Greg-R/qsd2/README.md

QSD2 Receiver Module

The documentation for this design is located here:
<https://kf5n.com/t41-2/qsd2ez/>
