Greg-R/qsd2/doc/qsd2.pdf

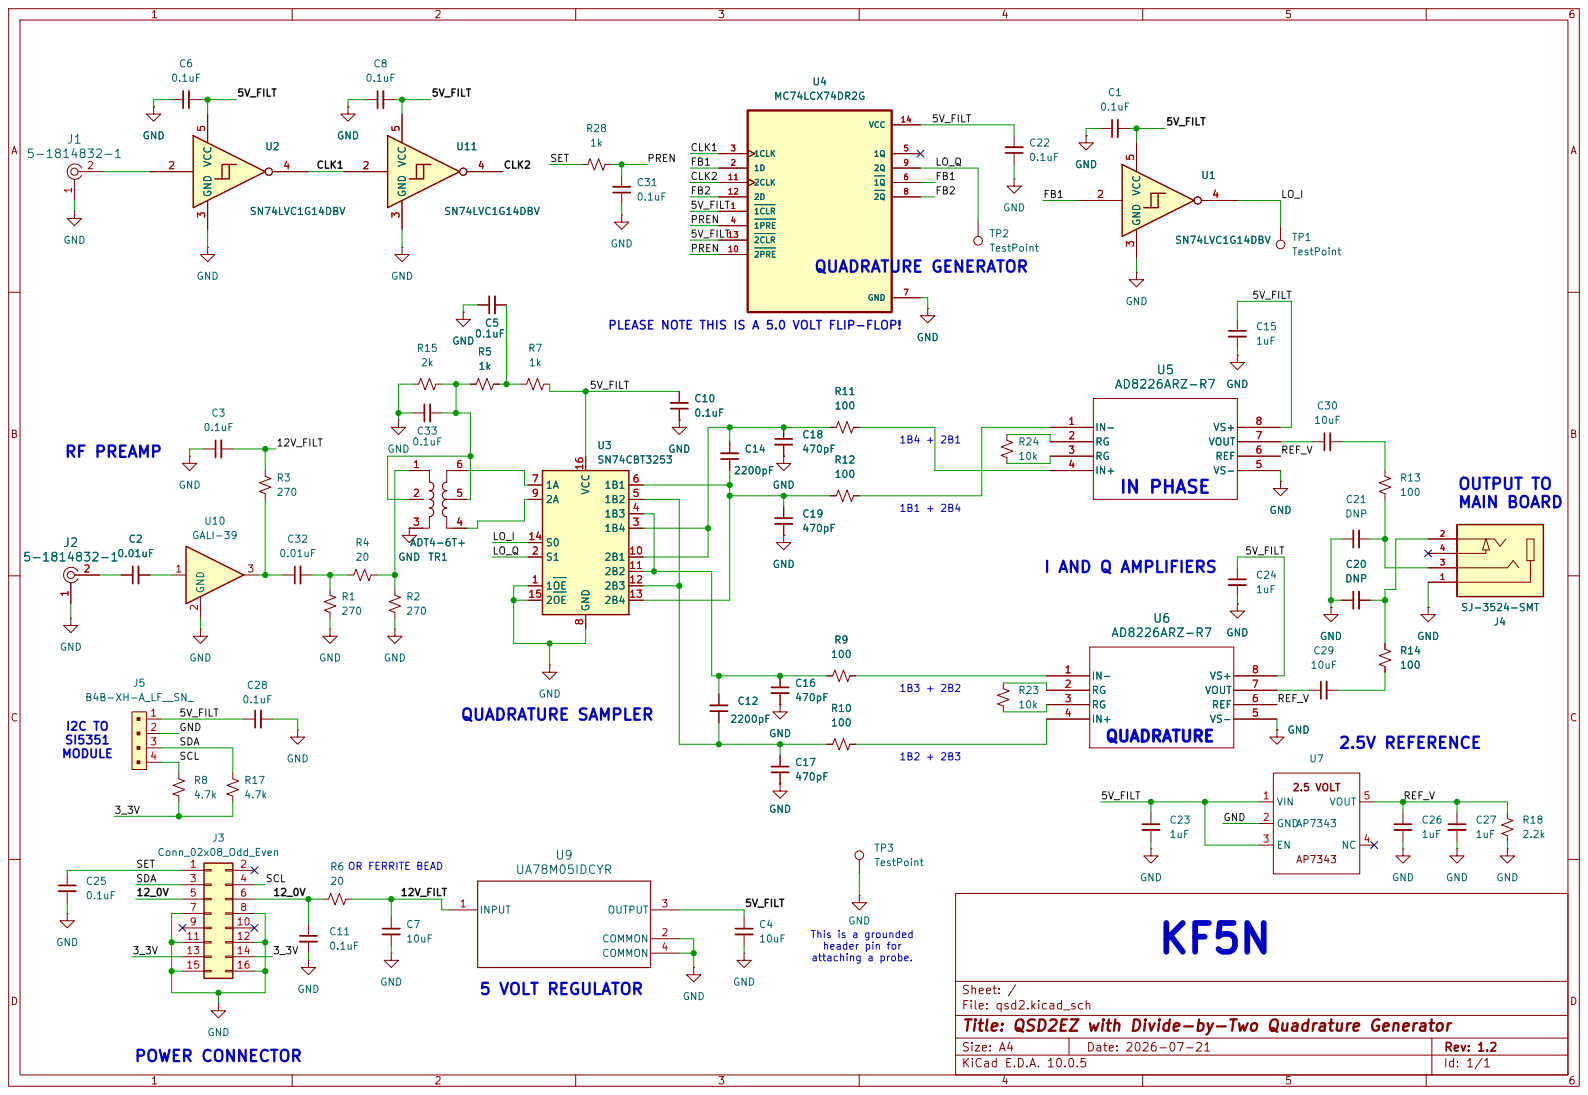
[picture p1: page 1]

This is a grounded
header pin for attaching a probe.

Sheet: /
File: qsd2.kicad_sch
Title: QSD2EZ with Divide-by-Two Quadrature Generator

Size: A4 | Rev: 1.2
KiCad E.D.A. 10.0.5 | Id: 1/1
