Greg-R/qsd2/qsd2.kicad_pcb

## KiCad design qsd2.kicad_pcb (2026-07-24)

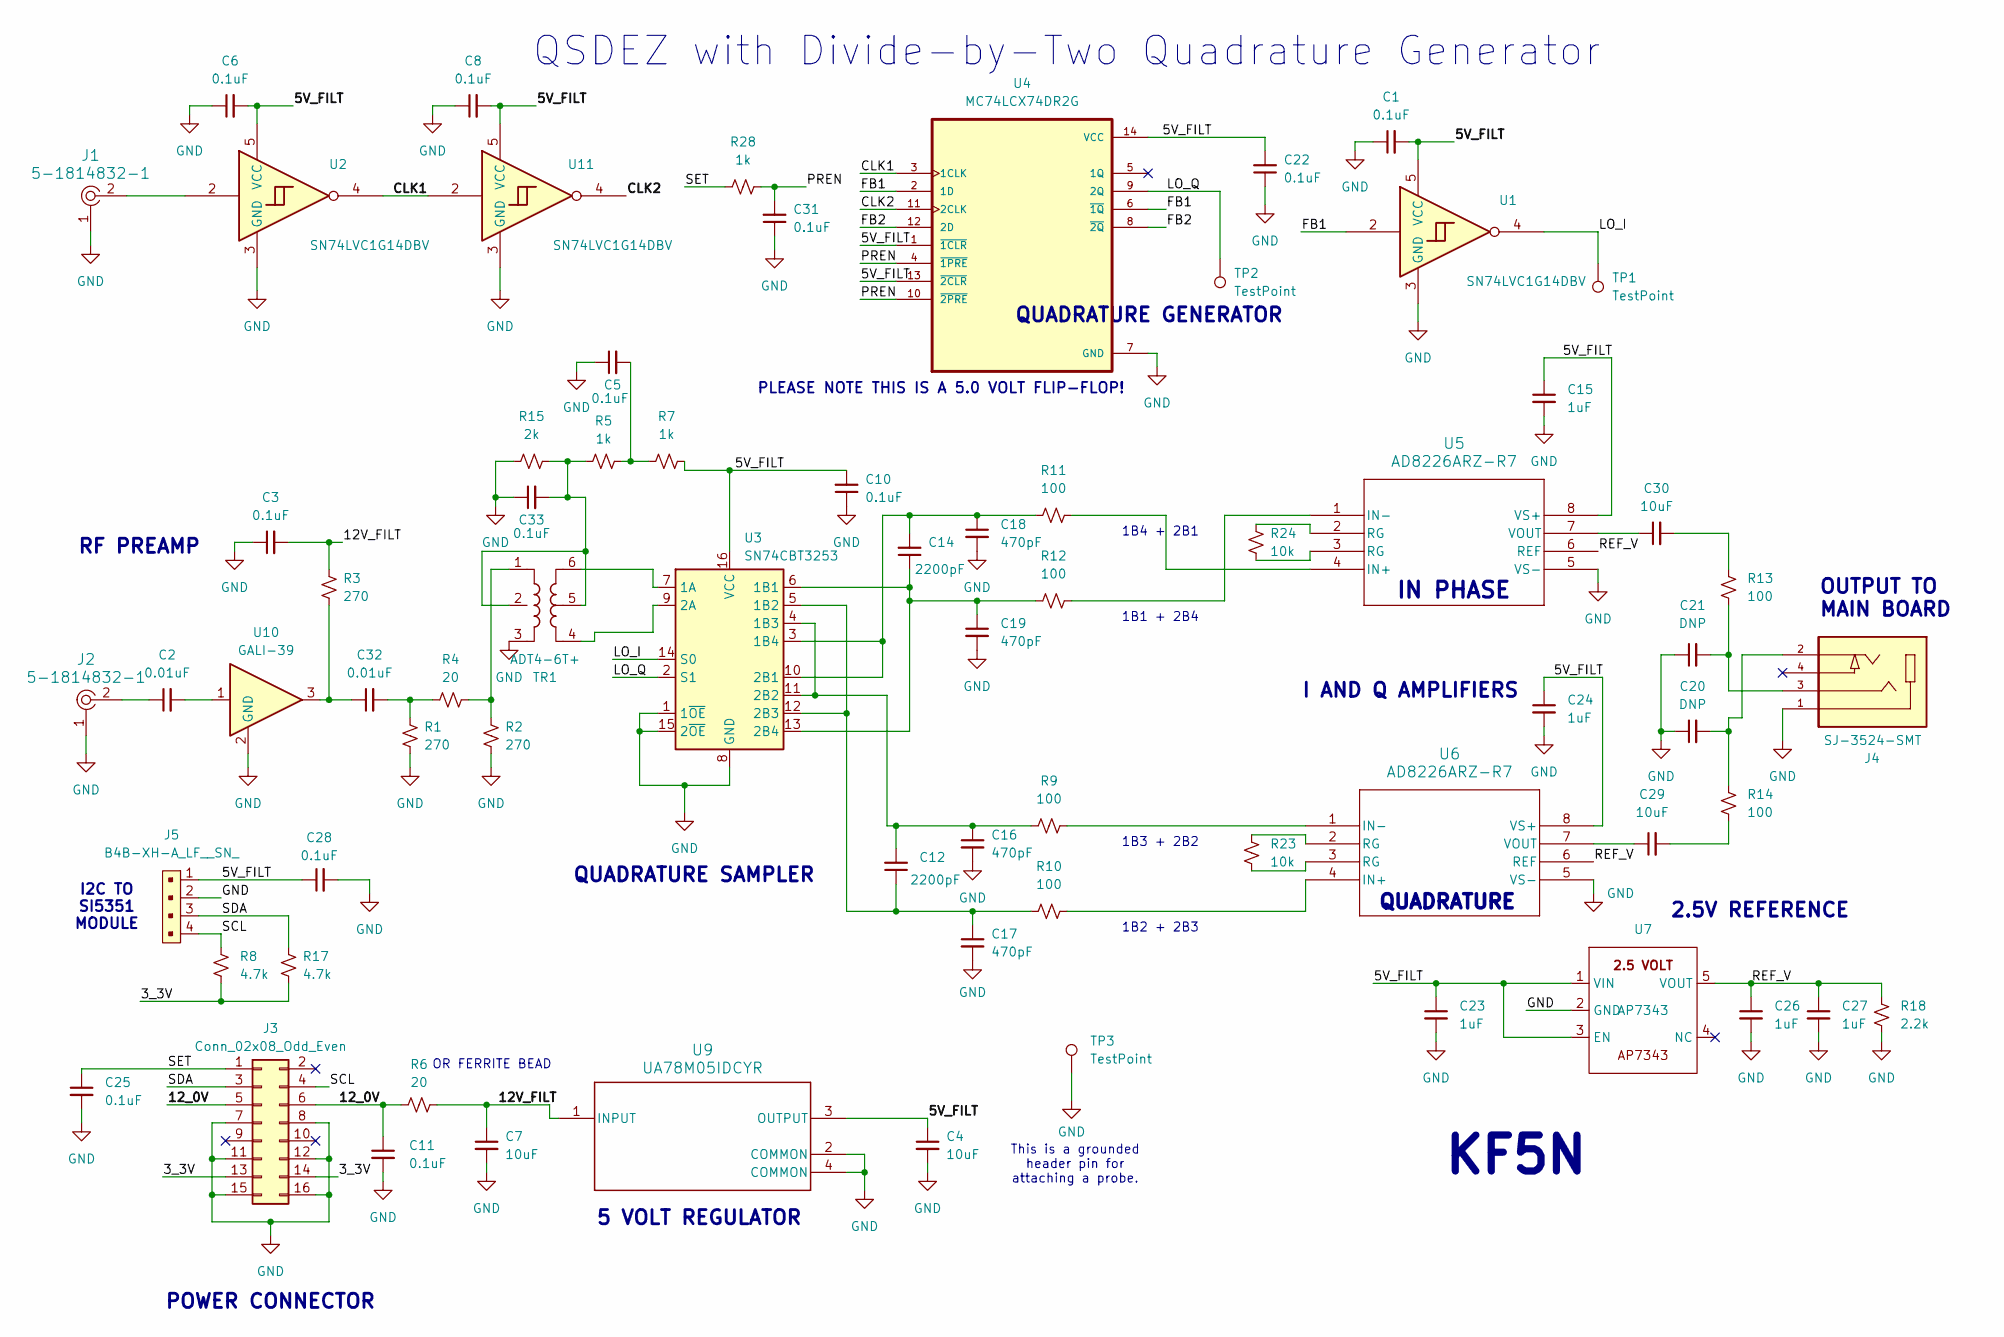
[picture p2: schematic qsd2.kicad_sch, QSD2EZ with Divide-by-Two Quadrature Generator]

Parts:
C1, C3, C5, C6, C8, C10, C11, C22, C25, C28, C31, C33: 0.1uF; C_1206_3216Metric
C2, C32: 0.01uF; C_1206_3216Metric
C4, C7, C29, C30: 10uF; C_1206_3216Metric
C12, C14: 2200pF; C_1206_3216Metric
C15, C23, C24, C26, C27: 1uF; C_1206_3216Metric
C16, C17, C18, C19: 470pF; C_1206_3216Metric
C20, C21: DNP; C_1206_3216Metric
J1, J2: 5-1814832-1; RF_SMA_Vertical_5-1814832-1; MPN 5-1814832-1; Digi-Key_PN A97594-ND
J3: Conn_02x08_Odd_Even; IDC-Header_2x08_P2.54mm_Vertical
J4: SJ-3524-SMT; CUI_SJ-3524-SMT; PARTREV 1.03
J5: B4B-XH-A_LF__SN_; PinHeader_1x4_P2.5mm_Drill1.1mm; MPN B4B-XH-A(LF)(SN); Digi-Key_PN 455-2249-ND
R1, R2, R3: 270; R_1206_3216Metric
R4, R6: 20; R_1206_3216Metric
R5, R7, R28: 1k; R_1206_3216Metric
R8, R17: 4.7k; R_1206_3216Metric
R9, R10, R11, R12, R13, R14: 100; R_1206_3216Metric
R15: 2k; R_1206_3216Metric
R18: 2.2k; R_1206_3216Metric
R23, R24: 10k; R_1206_3216Metric
TP1, TP2: TestPoint; TestPoint_Pad_D1.0mm
TP3: TestPoint; PinHeader_1x01_P2.54mm_Vertical
TR1: ADT4-6T+; Mini-Circuits_CD637_H5.23mm
U1, U2, U11: SN74LVC1G14DBV; SOT-23-5
U3: SN74CBT3253; SOIC-16_3.9x9.9mm_P1.27mm
U4: MC74LCX74DR2G; SOIC-14_3.9x8.7mm_P1.27mm
U5, U6: AD8226ARZ-R7; R_8_ADI
U7: AP7343; SOT-23-5
U9: UA78M05IDCYR; DCY0004A_N
U10: GALI-39; SOT-89-3

Connections:
/3_3V: J3.13, J3.14, R8.2, R17.2
/5V_FILT: C1.2, C4.1, C6.2, C8.2, C10.2, C15.1, C22.2, C23.1, C24.1, C28.1, J5.1, R7.2, U1.5 (VCC), U2.5 (VCC), U3.16 (VCC), U4.1 (~1CLR), U4.13 (~2CLR), U4.14 (VCC), U5.8 (VS+), U6.8 (VS+), U7.1 (VIN), U7.3 (EN), U9.3 (OUTPUT), U11.5 (VCC)
/12V_FILT: C3.2, C7.1, R3.1, R6.2, U9.1 (INPUT)
/12_0V: C11.1, J3.5, J3.6, R6.1
/CLK1: U2.4, U4.3 (1CLK), U11.2
/CLK2: U4.11 (2CLK), U11.4
/FB1: U1.2, U4.2 (1D), U4.6 (~1Q)
/FB2: U4.8 (~2Q), U4.12 (2D)
/LO_I: TP1.1 (1_1), U1.4, U3.14 (S0)
/LO_Q: TP2.1 (1_1), U3.2 (S1), U4.9 (2Q)
/PREN: C31.2, R28.2, U4.4 (~1PRE), U4.10 (~2PRE)
/REF_V: C26.1, C27.1, R18.1, U5.6 (REF), U6.6 (REF), U7.5 (VOUT)
/SCL: J3.4, J5.4, R8.1
/SDA: J3.3, J5.3, R17.1
/SET: C25.1, J3.1, R28.1
GND: C1.1, C3.1, C4.2, C5.1, C6.1, C7.2, C8.1, C10.1, C11.2, C15.2, C16.2, C17.2, C18.2, C19.2, C20.1, C21.1, C22.1, C23.2, C24.2, C25.2, C26.2, C27.2, C28.2, C31.1, C33.1, J1.1, J2.1, J3.7, J3.8, J3.11, J3.12, J3.15, J3.16, J4.1, J5.2, R1.2, R2.2, R15.1, R18.2, TP3.1 (1_1), TR1.3, U1.3 (GND), U2.3 (GND), U3.1 (1~OE), U3.8 (GND), U3.15 (2~OE), U4.7 (GND), U5.5 (VS-), U6.5 (VS-), U7.2 (GND), U9.2 (COMMON), U9.4 (COMMON), U10.2 (GND_2), U11.3 (GND)
unnamed: C2.1, J2.2
unnamed: C2.2, U10.1
unnamed: C5.2, R5.2, R7.1
unnamed: C20.2, J4.2, R14.2
unnamed: C21.2, J4.3, R13.1
unnamed: C29.2, R14.1
unnamed: C30.2, R13.2
unnamed: C32.1, R3.2, U10.3
unnamed: C32.2, R1.1, R4.1
unnamed: C33.2, R5.1, R15.2, TR1.2, TR1.5
unnamed: J1.2, U2.2
unnamed: R2.1, R4.2, TR1.1
unnamed: R23.1, U6.3 (RG)
unnamed: R23.2, U6.2 (RG)
unnamed: R24.1, U5.2 (RG)
unnamed: R24.2, U5.3 (RG)
unnamed: TR1.6, U3.7 (1A)
unnamed: C14.1, C19.1, R12.1, U3.6 (1B1), U3.13 (2B4)
unnamed: C12.1, C17.1, R10.1, U3.5 (1B2), U3.12 (2B3)
unnamed: C12.2, C16.1, R9.1, U3.4 (1B3), U3.11 (2B2)
unnamed: C14.2, C18.1, R11.1, U3.3 (1B4), U3.10 (2B1)
unnamed: TR1.4, U3.9 (2A)
unnamed: R11.2, U5.4 (IN+)
unnamed: R12.2, U5.1 (IN-)
unnamed: C30.1, U5.7 (VOUT)
unnamed: R10.2, U6.4 (IN+)
unnamed: R9.2, U6.1 (IN-)
unnamed: C29.1, U6.7 (VOUT)

Notes on the sheet:
KF5N
2.5V REFERENCE
OR FERRITE BEAD
5 VOLT REGULATOR
1B2 + 2B3
This is a grounded header pin for attaching a probe.
1B3 + 2B2
QUADRATURE
IN PHASE
QUADRATURE SAMPLER
PLEASE NOTE THIS IS A 5.0 VOLT FLIP-FLOP!
QUADRATURE GENERATOR
POWER CONNECTOR
RF PREAMP
1B4 + 2B1
OUTPUT TO MAIN BOARD
I AND Q AMPLIFIERS
1B1 + 2B4
I2C TO SI5351 MODULE
QSDEZ with Divide-by-Two Quadrature Generator

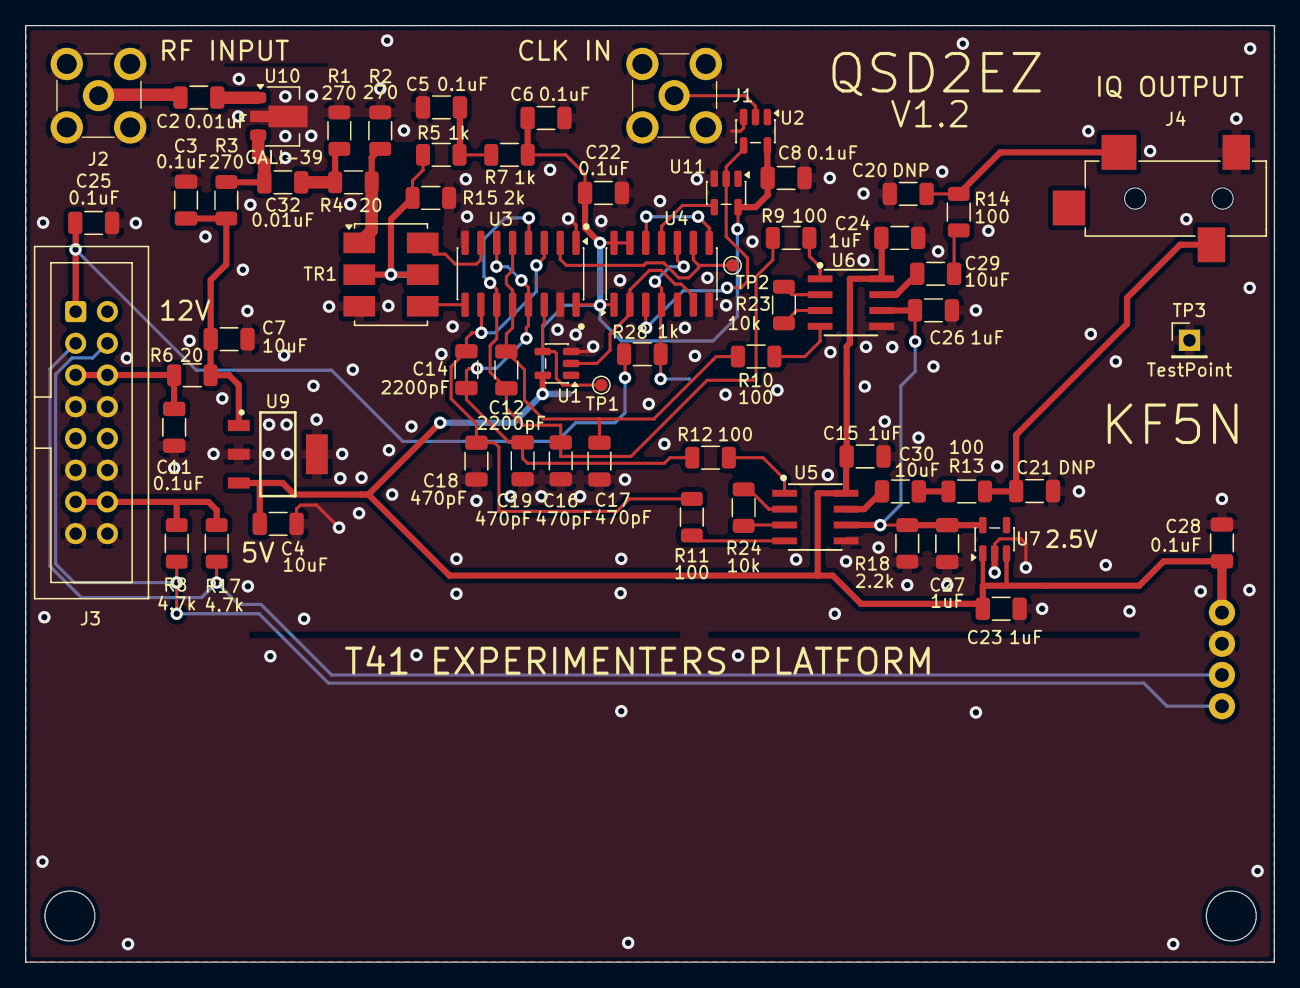
[picture p3: board qsd2.kicad_pcb from above]

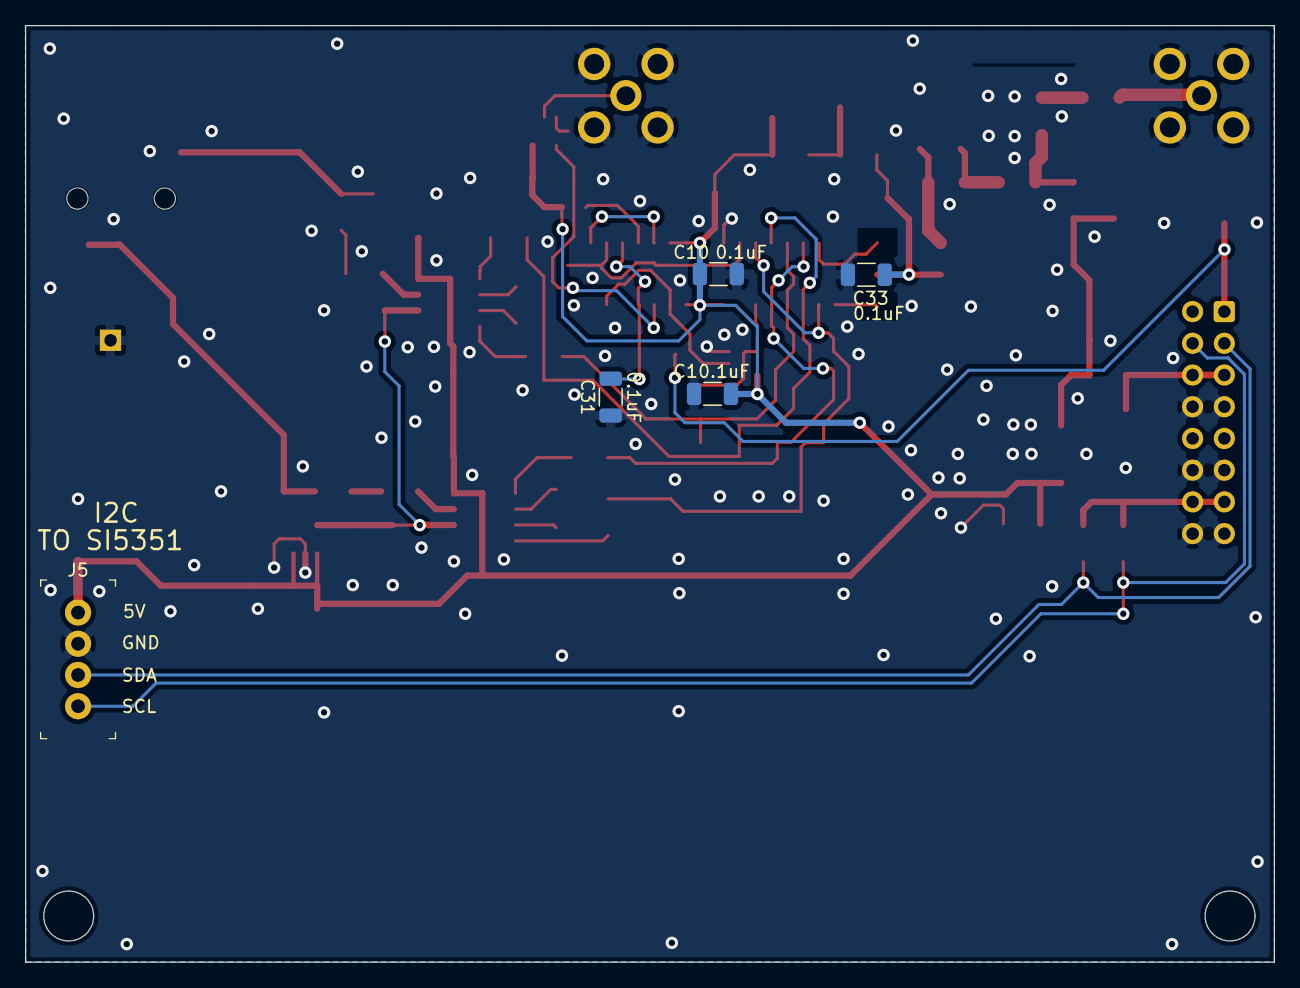
[picture p4: board qsd2.kicad_pcb from below]

Board: 2 copper layers, 100.0 x 75.0 mm, 70 parts (5 on the bottom side), 44 nets.
