Greg-R/qsd2/(commit log)

2023-10-19 Initial commit.
    [qsd2-B_Cu.gbl, qsd2-B_Mask.gbs, qsd2-B_Silkscreen.gbo, qsd2-Edge_Cuts.gm1, qsd2-F_Cu.gtl, qsd2-F_Mask.gts, qsd2-F_Silkscreen.gto, qsd2-NPTH.drl]
2023-10-19 Changed revision to 1.0.
    [qsd2.kicad_sch]
2023-10-27 Added PDF of schematic.
2023-10-28 Added link to public Digikey BOM.
2023-10-28 Minor updates to schematic.
    [qsd2.kicad_pcb, qsd2.kicad_sch]
2023-10-28 Added note on calibration.
2023-11-05 Updated README.md with build details.
    [qsd2.kicad_pcb]
2023-11-05 Very minor change to silkscreen. Two capacitors 3300pF to 2200pF.
    [qsd2-B_Cu.gbl, qsd2-B_Mask.gbs, qsd2-B_Silkscreen.gbo, qsd2-Edge_Cuts.gm1, qsd2-F_Cu.gtl, qsd2-F_Mask.gts, qsd2-F_Silkscreen.gto, qsd2-PTH.drl]
2023-11-06 Added photo of the Main board reset wire.
2023-11-17 Added README.md.
    [qsd2.kicad_pcb, qsd2.kicad_sch]
2023-11-18 Updated to version 1.1 PCB. Very minor changes.
    [qsd2-B_Cu.gbl, qsd2-B_Mask.gbs, qsd2-B_Silkscreen.gbo, qsd2-Edge_Cuts.gm1, qsd2-F_Cu.gtl, qsd2-F_Mask.gts, qsd2-F_Silkscreen.gto, qsd2-PTH.drl]
2023-11-18 Updated schematic PDF file.
2024-02-19 Mostly done rotating flip-flop and detector.
    [qsd2.kicad_pcb, qsd2.kicad_sch]
2024-02-20 Gerbers done, ready to release V1.1.
    [qsd2-B_Cu.gbl, qsd2-B_Mask.gbs, qsd2-B_Silkscreen.gbo, qsd2-Edge_Cuts.gm1, qsd2-F_Cu.gtl, qsd2-F_Mask.gts, qsd2-F_Silkscreen.gto, qsd2-NPTH.drl]
2024-02-20 Minor clean-up of a few vias.
    [qsd2-B_Cu.gbl, qsd2-B_Mask.gbs, qsd2-B_Silkscreen.gbo, qsd2-Edge_Cuts.gm1, qsd2-F_Cu.gtl, qsd2-F_Mask.gts, qsd2-F_Silkscreen.gto, qsd2-PTH.drl]
2024-02-29 Ready to publish version 1.1.
    [qsd2-B_Cu.gbl, qsd2-B_Mask.gbs, qsd2-B_Silkscreen.gbo, qsd2-Edge_Cuts.gm1, qsd2-F_Cu.gtl, qsd2-F_Mask.gts, qsd2-F_Silkscreen.gto, qsd2-NPTH.drl]
2024-03-03 Removed gerber archive from repository.
    [qsd2-B_Cu.gbl, qsd2-B_Mask.gbs, qsd2-B_Silkscreen.gbo, qsd2-Edge_Cuts.gm1, qsd2-F_Cu.gtl, qsd2-F_Mask.gts, qsd2-F_Silkscreen.gto, qsd2-NPTH.drl]
2024-04-28 QSD2EZ to V1.0 fab.
    [qsd2-B_Cu.gbl, qsd2-B_Mask.gbs, qsd2-B_Silkscreen.gbo, qsd2-Edge_Cuts.gm1, qsd2-F_Cu.gtl, qsd2-F_Mask.gts, qsd2-F_Silkscreen.gto, qsd2-NPTH.drl]
2024-05-07 Moved resistor value to more logical location.
    [qsd2.kicad_pcb]
2024-05-07 Updated README.
    [qsd2.kicad_sch]
2025-07-02 Updated to new version Kicad.
    [qsd2.kicad_pcb]
2026-03-11 Updated Kicad version files.
    [qsd2.kicad_sch]
2026-05-20 Added 4 pin connector with 5V and I2C for Si5351 module.
    [qsd2.kicad_pcb]
2026-05-21 Ready for fab QSD2EZ V1.1 May 21, 2026.
    [qsd2-B_Cu.gbl, qsd2-B_Mask.gbs, qsd2-B_Silkscreen.gbo, qsd2-Edge_Cuts.gm1, qsd2-F_Cu.gtl, qsd2-F_Mask.gts, qsd2-F_Silkscreen.gto, qsd2-NPTH.drl]
2026-07-13 V1.2 to fab.
    [qsd2-B_Cu.gbl, qsd2-B_Mask.gbs, qsd2-B_Silkscreen.gbo, qsd2-Edge_Cuts.gm1, qsd2-F_Cu.gtl, qsd2-F_Mask.gts, qsd2-F_Silkscreen.gto, qsd2-NPTH.drl]
2026-07-13 Generated new schematic PDF.
2026-07-21 Changed 10 ohm resistor to 20. Fixed missing component value.
    [qsd2.kicad_pcb, qsd2.kicad_sch]
2026-07-23 Cleaned up minor details in schematic.
    [qsd2.kicad_pcb, qsd2.kicad_sch]
2026-07-23 Updated PDF schematic.
2026-07-23 Generated new Gerbers.
